paulbrouwersnz/3d-chore-board/renders/mounting/adhesive_strips.png

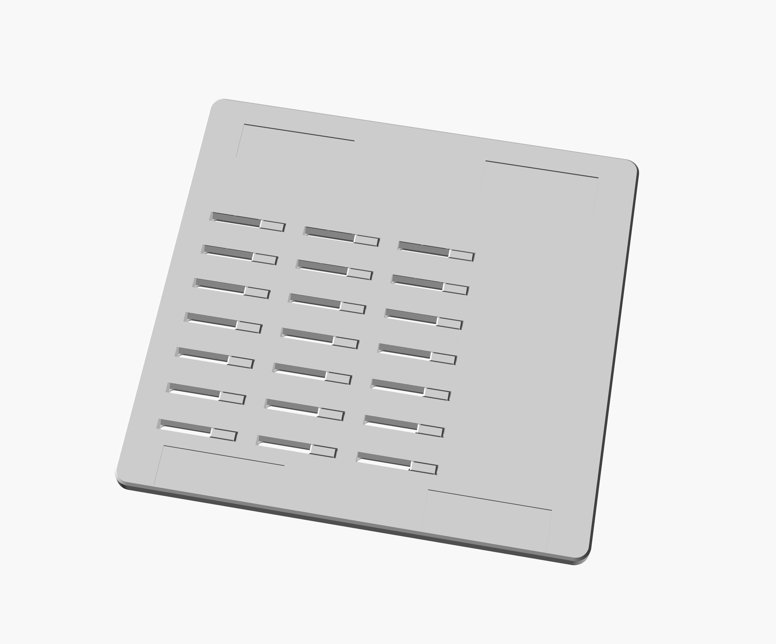
renders/mounting/adhesive_strips.png
