paulbrouwersnz/3d-chore-board/renders/mounting/door_hooks.png

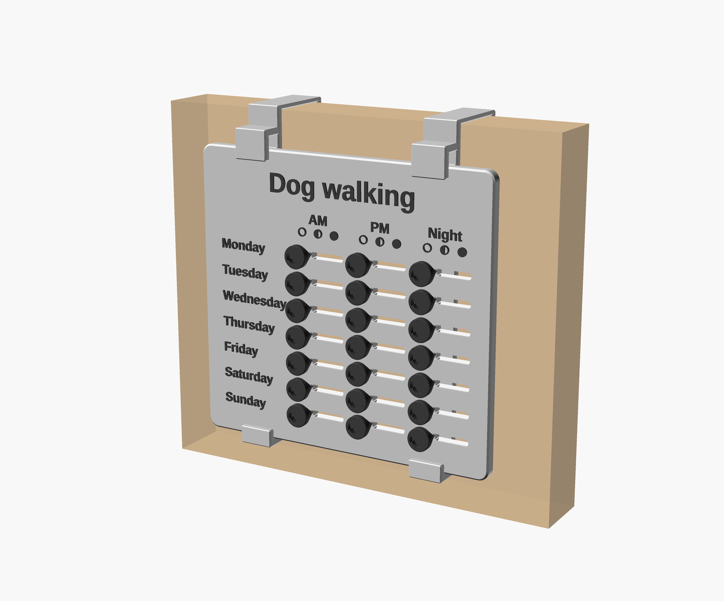
renders/mounting/door_hooks.png
