paulbrouwersnz/3d-chore-board/renders/mounting/door_hooks_side.png

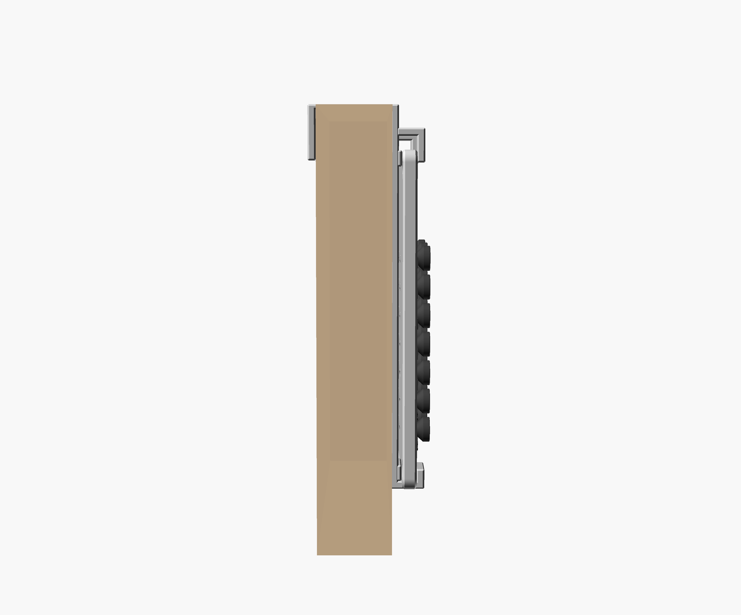
renders/mounting/door_hooks_side.png
