paulbrouwersnz/3d-chore-board/renders/mounting/french_cleat.png

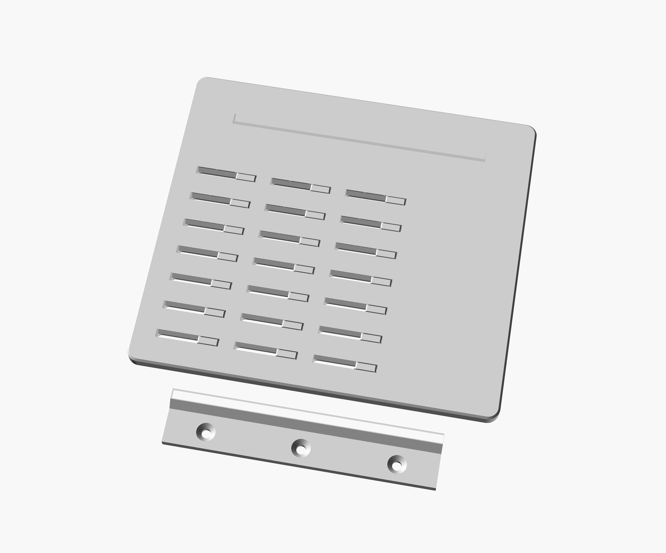
renders/mounting/french_cleat.png
