paulbrouwersnz/3d-chore-board/renders/mounting/stand.png

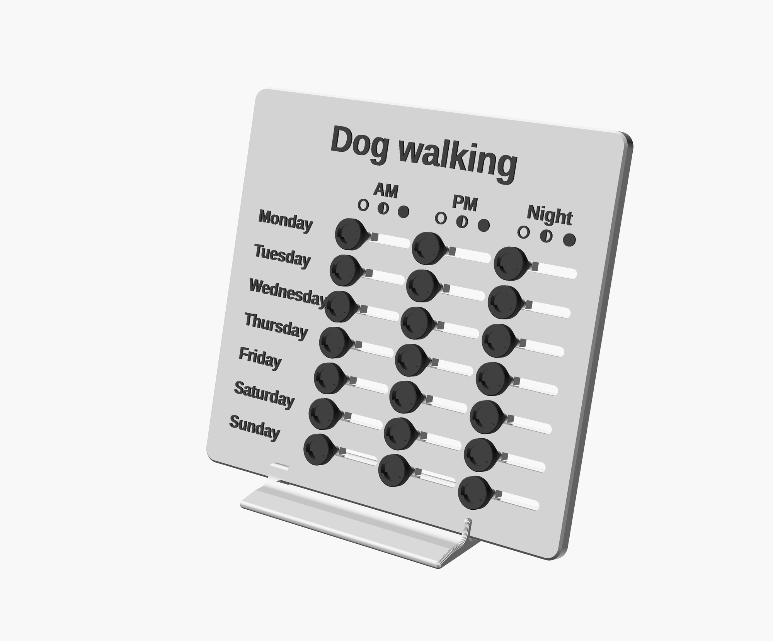
renders/mounting/stand.png
