paulbrouwersnz/3d-chore-board/renders/token_bone_twist.png

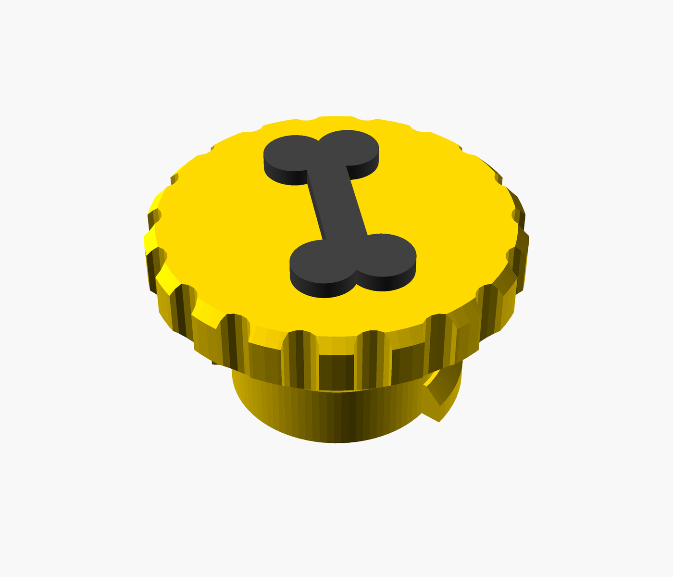
renders/token_bone_twist.png
