paulbrouwersnz/3d-chore-board/renders/token_paw_twist.png

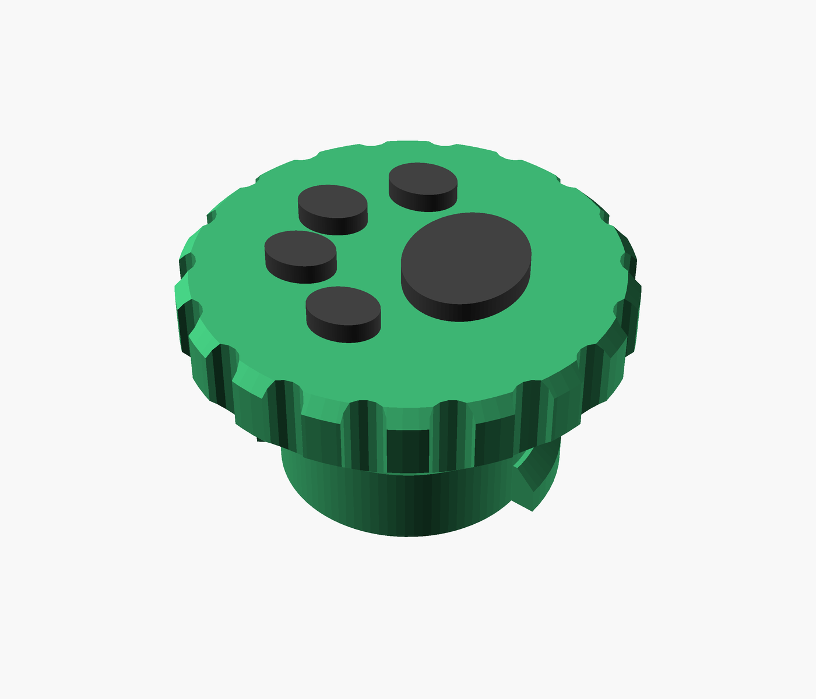
renders/token_paw_twist.png
