paulbrouwersnz/3d-chore-board/renders/tray.png

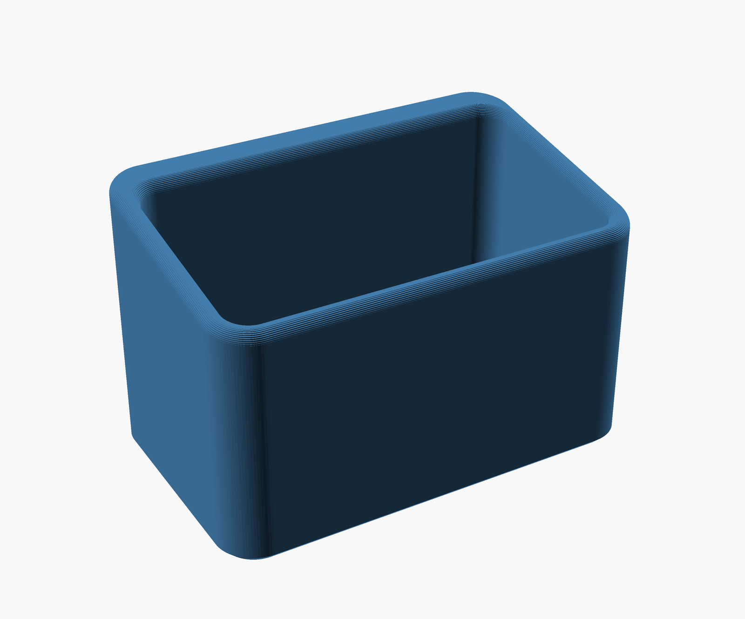
renders/tray.png
