paulbrouwersnz/3d-chore-board/exports/slider_test_twist.stl

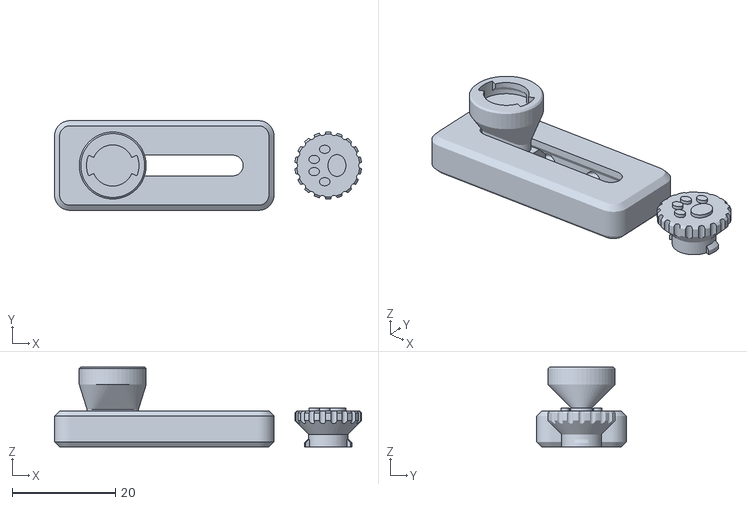
[picture p10: CAD file, 2026-10-15]
exports/slider_test_twist.stl
59.6 x 17.4 x 15.5
