paulbrouwersnz/3d-chore-board/prints/board_twist_stand.3mf

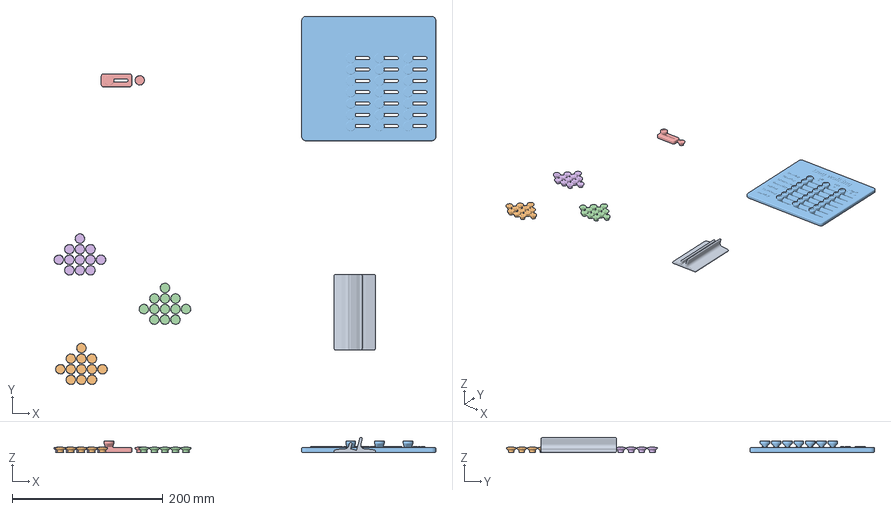
[picture p11: CAD file, 2026-10-15]
prints/board_twist_stand.3mf
506.2 x 488.1 x 20.0 mm
board_twist_stand.stl_B
Assembly x 3
board_twist_stand.stl_A
slider_test_twist.stl
