paulbrouwersnz/3d-chore-board/exports/slider_test_twist_tabs.stl

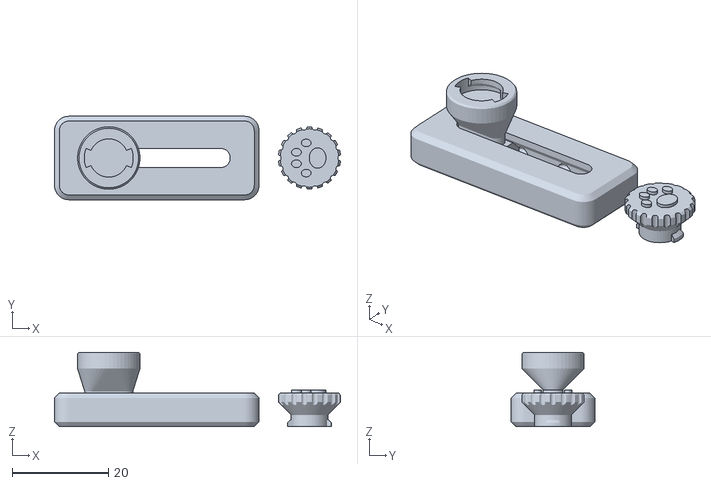
[picture p12: CAD file, 2026-10-15]
exports/slider_test_twist_tabs.stl
59.6 x 17.4 x 15.5
