paulbrouwersnz/3d-chore-board/exports/board_stand.stl

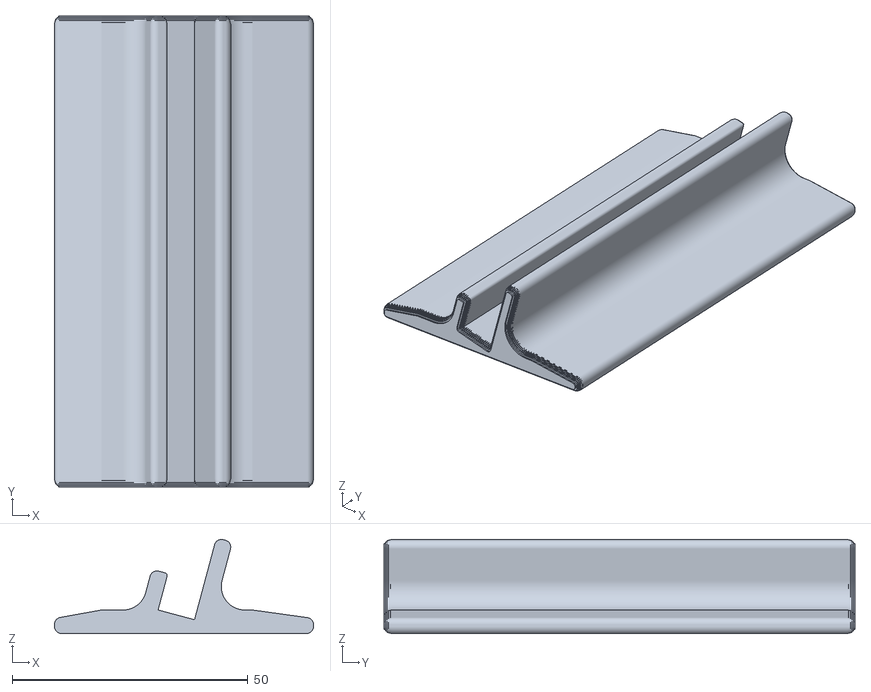
[picture p13: CAD file, 2026-10-15]
exports/board_stand.stl
55.0 x 100.0 x 20.0
