paulbrouwersnz/3d-chore-board/exports/token_heart_twist.stl

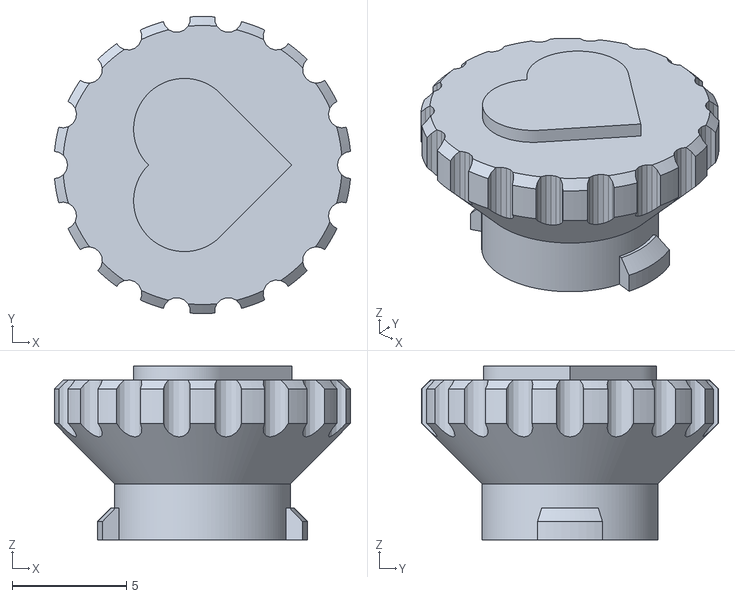
[picture p14: CAD file, 2026-10-15]
exports/token_heart_twist.stl
12.9 x 13.0 x 7.60
