paulbrouwersnz/3d-chore-board/exports/tray.stl

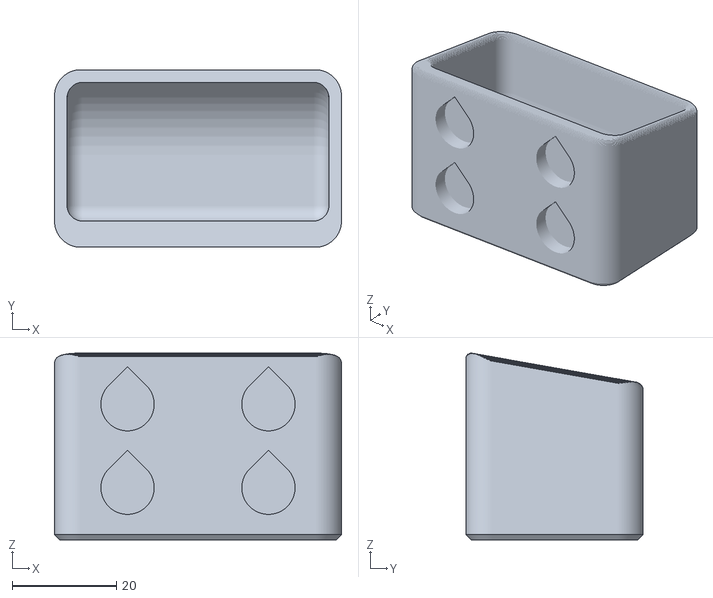
[picture p15: CAD file, 2026-10-15]
exports/tray.stl
55.0 x 34.0 x 35.8
