paulbrouwersnz/3d-chore-board/exports/token_bone_twist.stl

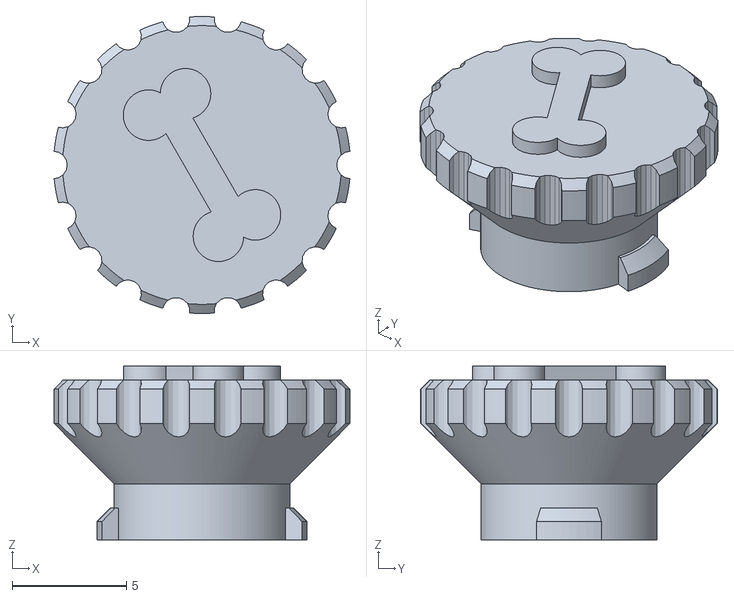
[picture p16: CAD file, 2026-10-15]
exports/token_bone_twist.stl
12.9 x 13.0 x 7.60
