paulbrouwersnz/3d-chore-board/(list of files, cad)

Other CAD files:
exports/token_paw_twist.stl
