paulbrouwersnz/3d-chore-board/renders/slider_test_twist.png

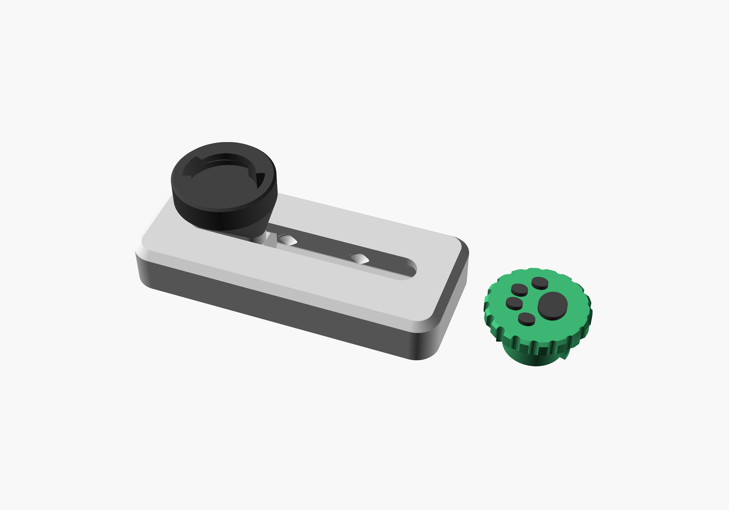
renders/slider_test_twist.png
