paulbrouwersnz/3d-chore-board/(commit log)

2026-10-15 First attempt
    [chore_board.scad, slider_test_twist.stl, token_bone_twist.stl, token_heart_twist.stl, token_paw_twist.stl, tray.stl]
2026-10-15 Added project file and separate stand
    [board_stand.stl, board_twist_stand.3mf]
2026-10-15 Updated project notes
    [board_twist_stand.3mf]
2026-10-15 Added a tabs option for the sliders to help with printing.
    [chore_board.scad, slider_test_twist.stl, slider_test_twist_tabs.stl]
